eddylau328/fyp-artificial-intelligence-ac-control-device/item_list.md

# Item Lists
## AC Remote Device
### Electronic components
1. Arduino Mega 2560 x1
2. NodeMCU x1
    - [NodeMCU taobao link](https://detail.tmall.com/item.htm?id=524942473974&spm=a1z09.2.0.0.40b42e8dqUuZrI&_u=p2v57gsh5d21)
3. ir receiver x1
    - VS1838B , 38kHz
    - [VS1838B taobao link](https://item.taobao.com/item.htm?spm=a1z09.2.0.0.40b42e8dqUuZrI&id=178521861&_u=p2v57gshd1d6)
4. IR transmitter x1
    - IR LED
    - [IR LED taobao link](https://item.taobao.com/item.htm?spm=a1z09.2.0.0.40b42e8dqUuZrI&id=43647329043&_u=p2v57gshd036)
5. temperature & humidity sensor x1
    - HTU21D
    - [HTU21D taobao link](https://detail.tmall.com/item.htm?id=521686770579&spm=a1z09.2.0.0.40b42e8dqUuZrI&_u=p2v57gshe34b)
6. light sensor x1
    - BH1750
    - [BH1750 taobao link](https://detail.tmall.com/item.htm?id=521238059334&spm=a1z09.2.0.0.40b42e8dqUuZrI&_u=p2v57gshe0f9)
7. Barometric Pressor Sensor x1
    - BMP180
    - [BMP180 taobao link](https://detail.tmall.com/item.htm?id=521331189285&spm=a1z09.2.0.0.40b42e8dqUuZrI&_u=p2v57gsh1a64)

## Smartwatch Device
### Electronic components
1. Heart rate sensor x1
    - MAX30102
    - [MAX30102 taobao link](https://detail.tmall.com/item.htm?spm=a1z0d.6639537.1997196601.31.53377484Wh1uwb&id=576026624239)
2. Body temperature sensor x1
    - LM35
    - [LM35 taobao link](https://detail.tmall.com/item.htm?spm=a1z0d.6639537.1997196601.54.199b74845QygUJ&id=41414863412)
3. Low power LCD monitor x1
    - 0.96inch OLED monitor
    - [OLED monitor taobao link](https://detail.tmall.com/item.htm?spm=a1z0d.6639537.1997196601.28.199b74845QygUJ&id=555789848567)
4. ESP32 x1
    - bluetooth function provided
    - [esp32 taobao link](https://detail.tmall.com/item.htm?id=555740879447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)
5. Lithium Battery 3.7V x1
    - 2000 mah
    - [li battery taobao link](https://detail.tmall.com/item.htm?spm=a1z0d.6639537.1997196601.82.199b74845QygUJ&id=605011214807)
6. 3.3V DC-DC regulator
    - [regulator link](https://item.taobao.com/item.htm?spm=a1z09.2.0.0.74a22e8df6DqSQ&id=558518174418&_u=n2v57gsh9e70)

### Hardware components
1. wristband x1
    - [taobao link](https://detail.tmall.com/item.htm?spm=a1z0d.6639537.1997196601.14.bf1e7484fpfouG&id=585651198278)

## Power Meter
### Electronic components
1. Plug-in Power meter x1
    - [taobao link](https://detail.tmall.com/item.htm?spm=a1z0d.6639537.1997196601.119.199b74845QygUJ&id=590305202754)
2. Power meter module x1
    - PZEM-004T
    - [taobao link](https://item.taobao.com/item.htm?spm=a1z0d.6639537.1997196601.105.199b74845QygUJ&id=583138602232)
3. CT sensor x1
    - [taobao link](https://item.taobao.com/item.htm?spm=a1z0d.6639537.1997196601.105.199b74845QygUJ&id=583138602232)
4. atmega328 x1
    - [taobao link](https://detail.tmall.com/item.htm?spm=a1z0d.6639537.1997196601.4.199b74845QygUJ&id=595282328171)
5. LCD monitor x1
    - LCD 1602
    - [taobao link](https://detail.tmall.com/item.htm?spm=a1z0d.6639537.1997196601.72.199b74845QygUJ&id=16000820397)

## Air Conditioner
### PAC-208
[Carousell link](https://hk.carousell.com/p/%E7%A7%BB%E5%8B%95%E5%BC%8F%E5%86%B7%E6%B0%A3%E6%A9%9F-255165199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)
