eddylau328/fyp-artificial-intelligence-ac-control-device/fyp presentation/d13134be-79b7-4a4c-ba2b-299e0d3491b8.jpeg

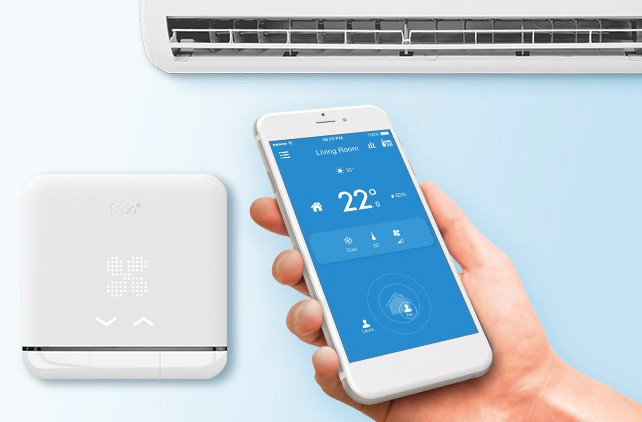
fyp presentation/d13134be-79b7-4a4c-ba2b-299e0d3491b8.jpeg
