eddylau328/fyp-artificial-intelligence-ac-control-device/fyp presentation/nuevo-mijia-smart-air-conditioner-2.jpg

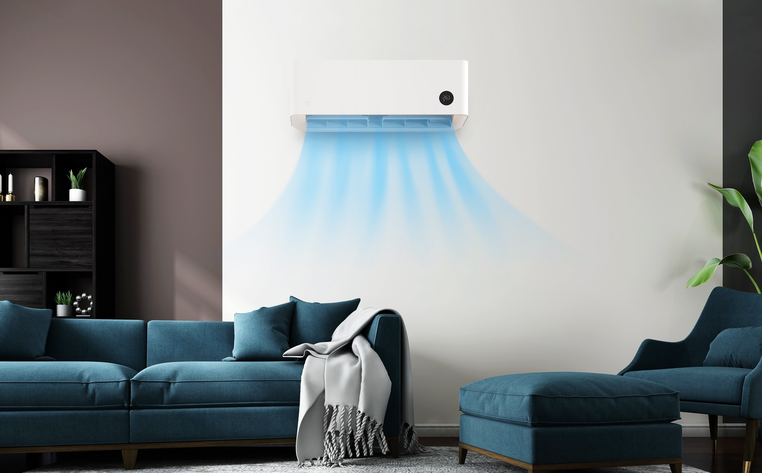
fyp presentation/nuevo-mijia-smart-air-conditioner-2.jpg
