eddylau328/fyp-artificial-intelligence-ac-control-device/fyp presentation/Screenshot from 2020-05-10 17-11-20.png

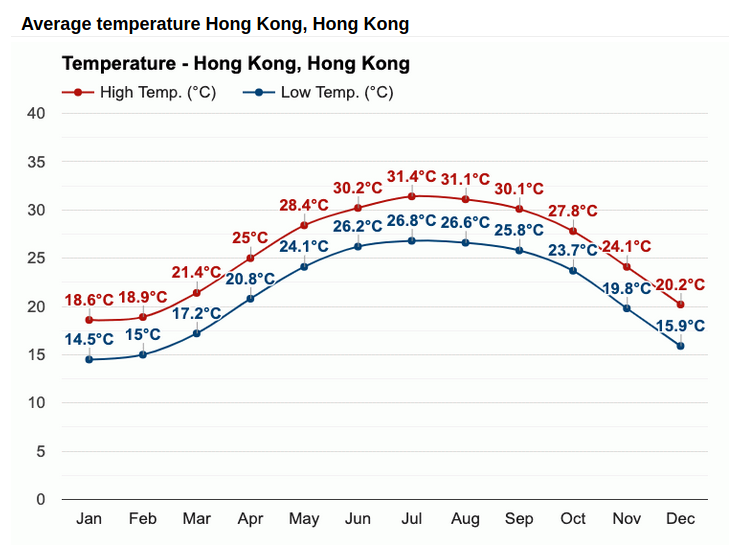
fyp presentation/Screenshot from 2020-05-10 17-11-20.png
