eddylau328/fyp-artificial-intelligence-ac-control-device/fyp presentation/Screenshot from 2020-05-11 08-19-18.png

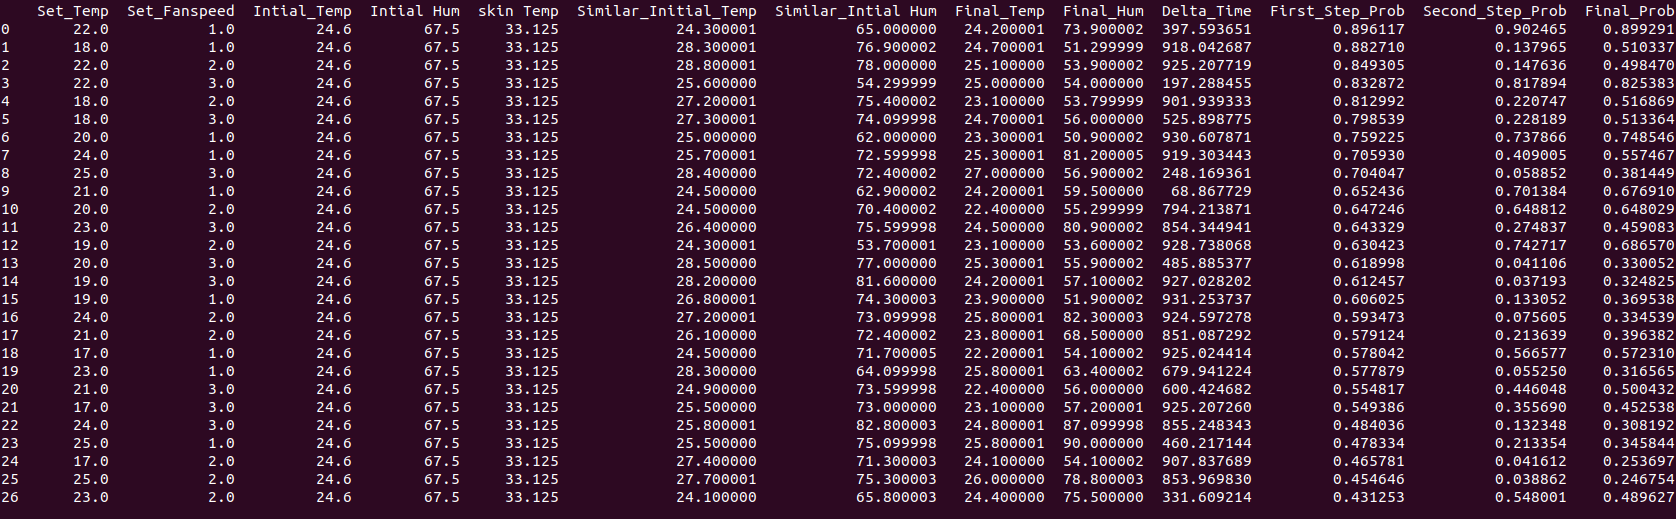
fyp presentation/Screenshot from 2020-05-11 08-19-18.png
