eddylau328/fyp-artificial-intelligence-ac-control-device/Machine_Learning/Supervised Learning Model.png

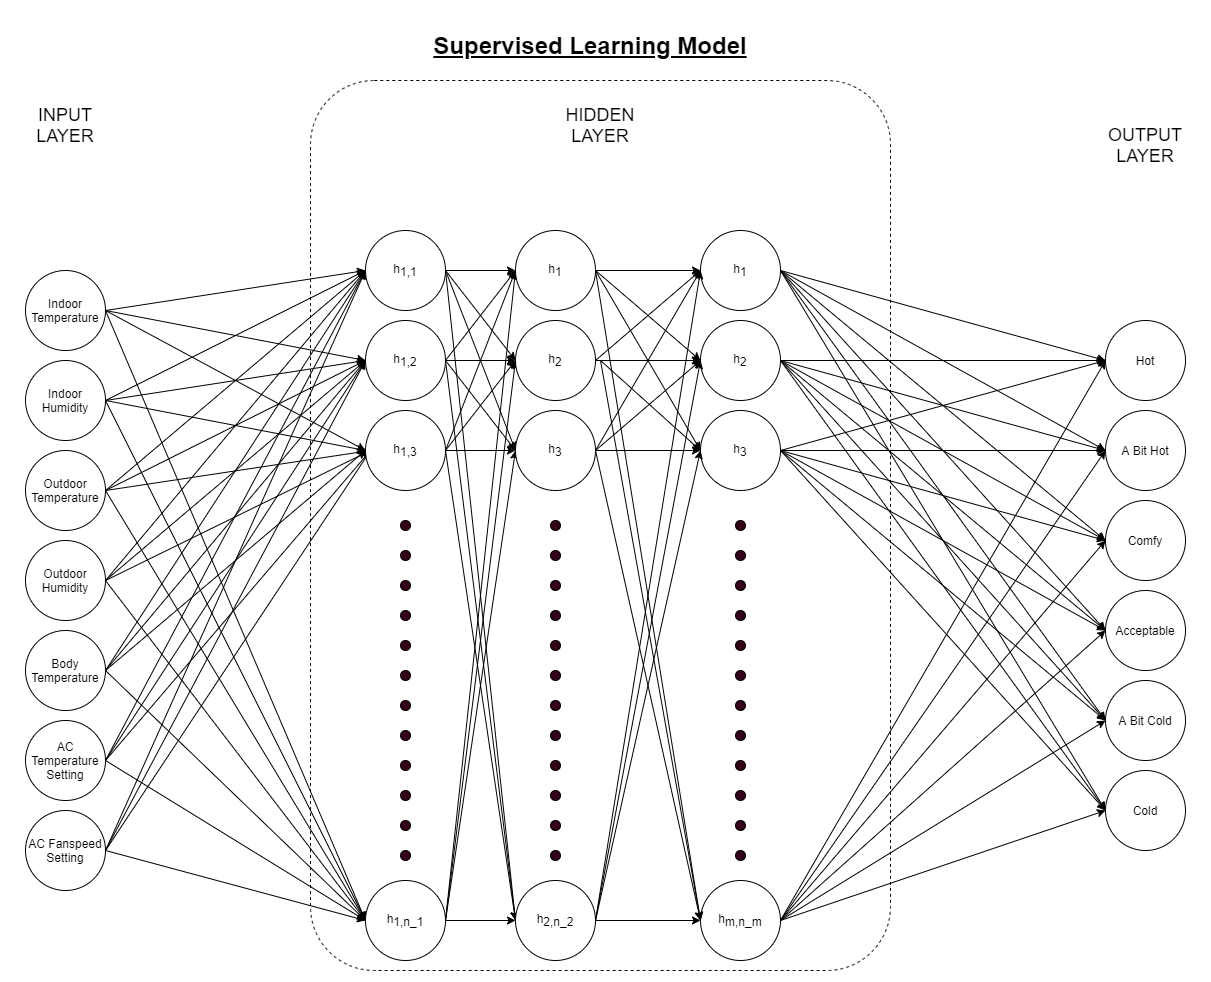
Machine_Learning/Supervised Learning Model.png
