eddylau328/fyp-artificial-intelligence-ac-control-device/Project Record/AC remote DEV/Online database communication/pic_send_data_to_firebase_connection.jpeg

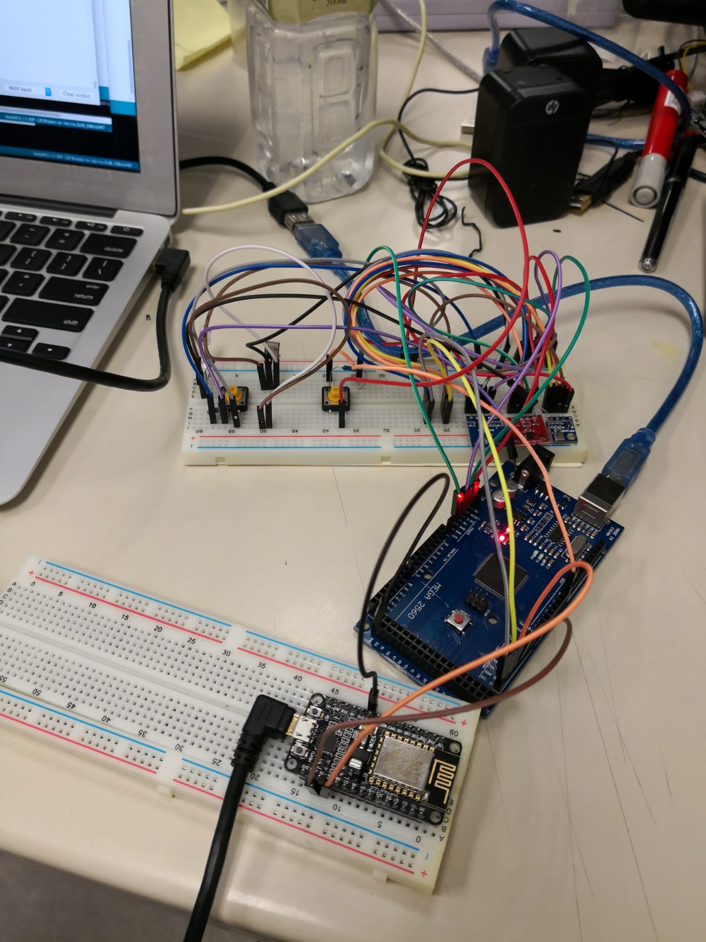
Project Record/AC remote DEV/Online database communication/pic_send_data_to_firebase_connection.jpeg
