eddylau328/fyp-artificial-intelligence-ac-control-device/Project Record/explaination/3_plot_temp_hum_skin.png

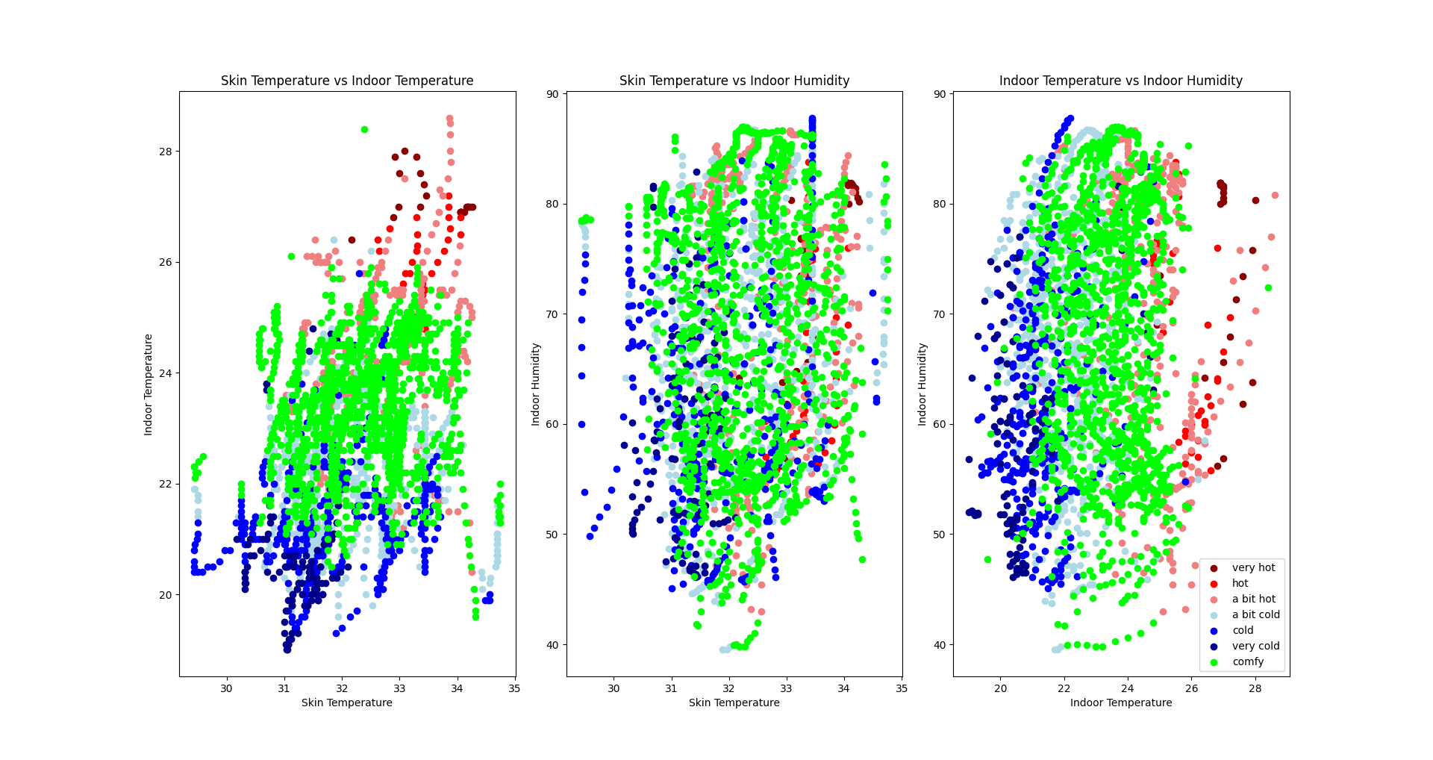
Project Record/explaination/3_plot_temp_hum_skin.png
