eddylau328/fyp-artificial-intelligence-ac-control-device/Project Record/explaination/3d_plot_temp_hum_skin_temp.png

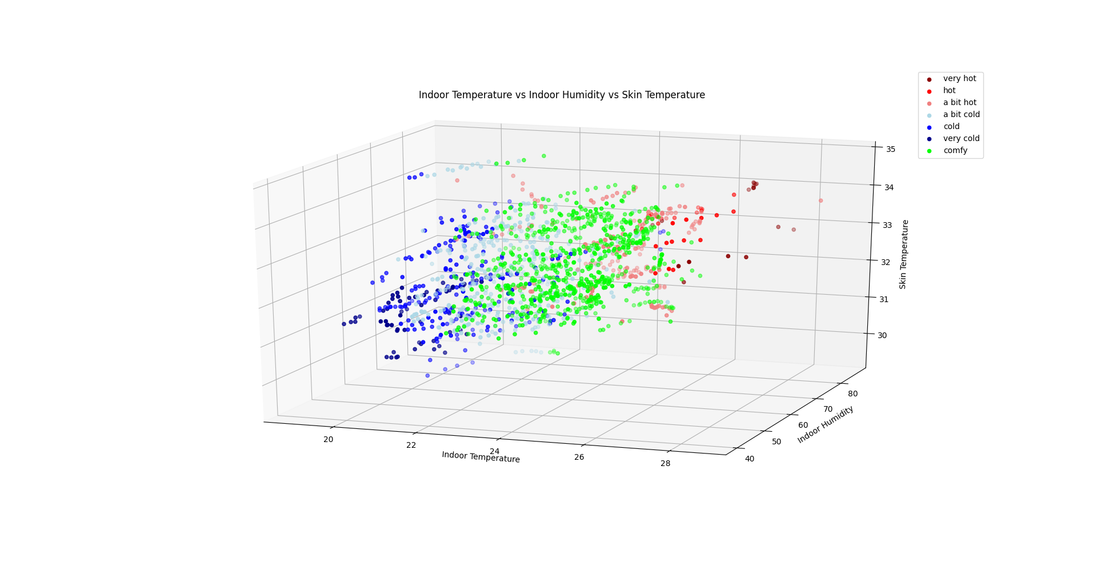
Project Record/explaination/3d_plot_temp_hum_skin_temp.png
