eddylau328/fyp-artificial-intelligence-ac-control-device/Project Record/explaination/correlation_heatmap.png

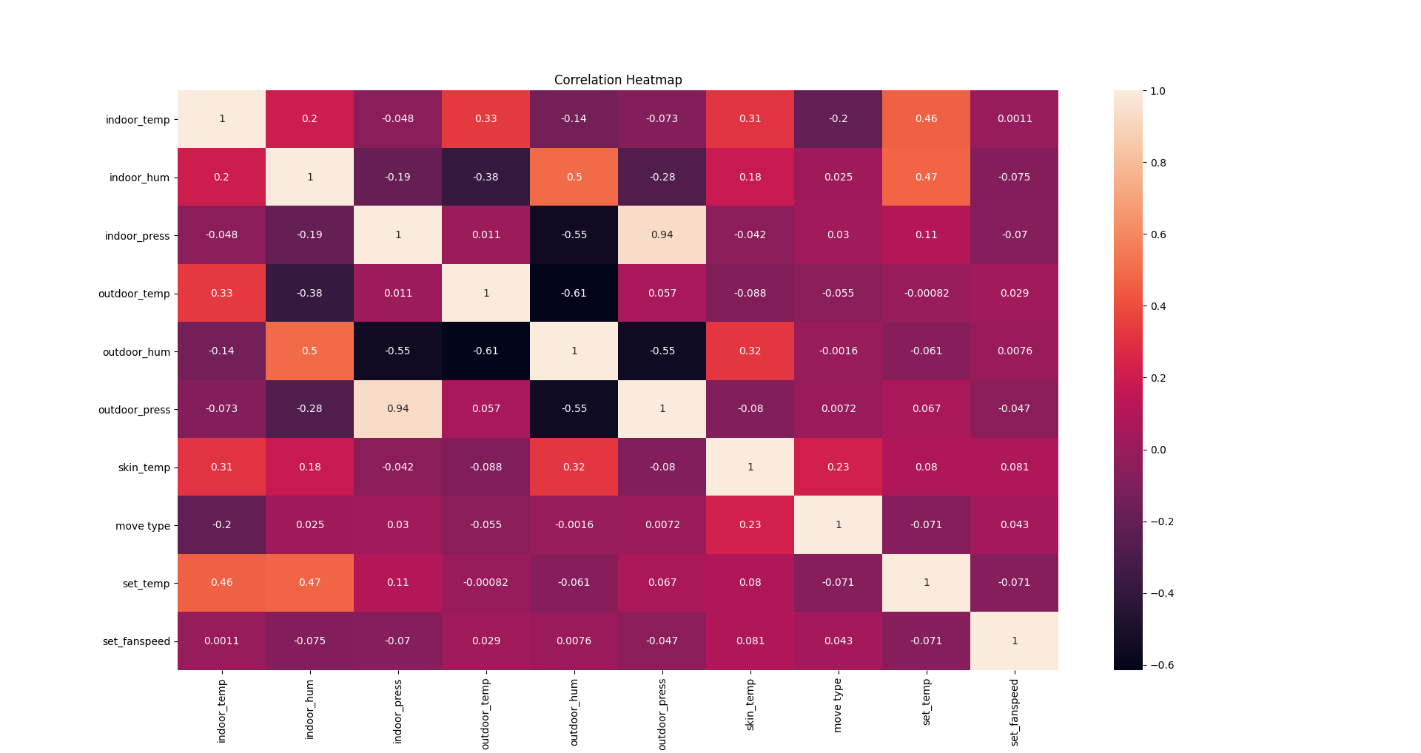
Project Record/explaination/correlation_heatmap.png
