eddylau328/fyp-artificial-intelligence-ac-control-device/Project Record/explaination/firebase_realtime_database_class_diagram.png

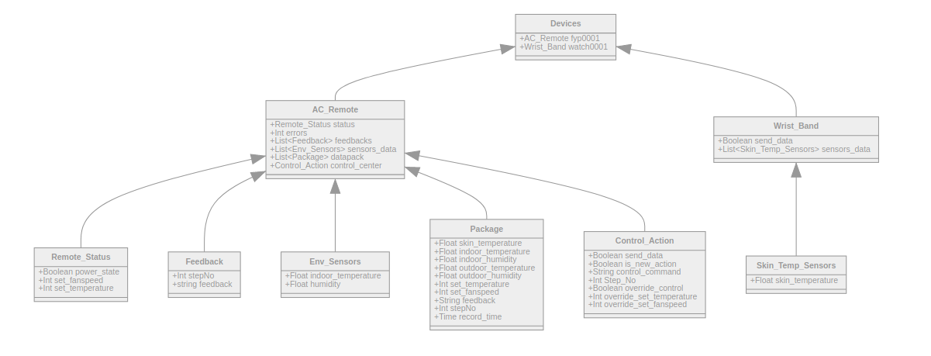
Project Record/explaination/firebase_realtime_database_class_diagram.png
