eddylau328/fyp-artificial-intelligence-ac-control-device/Project Record/explaination/indoor_humidity_thermal_comfort_level_probability_density.png

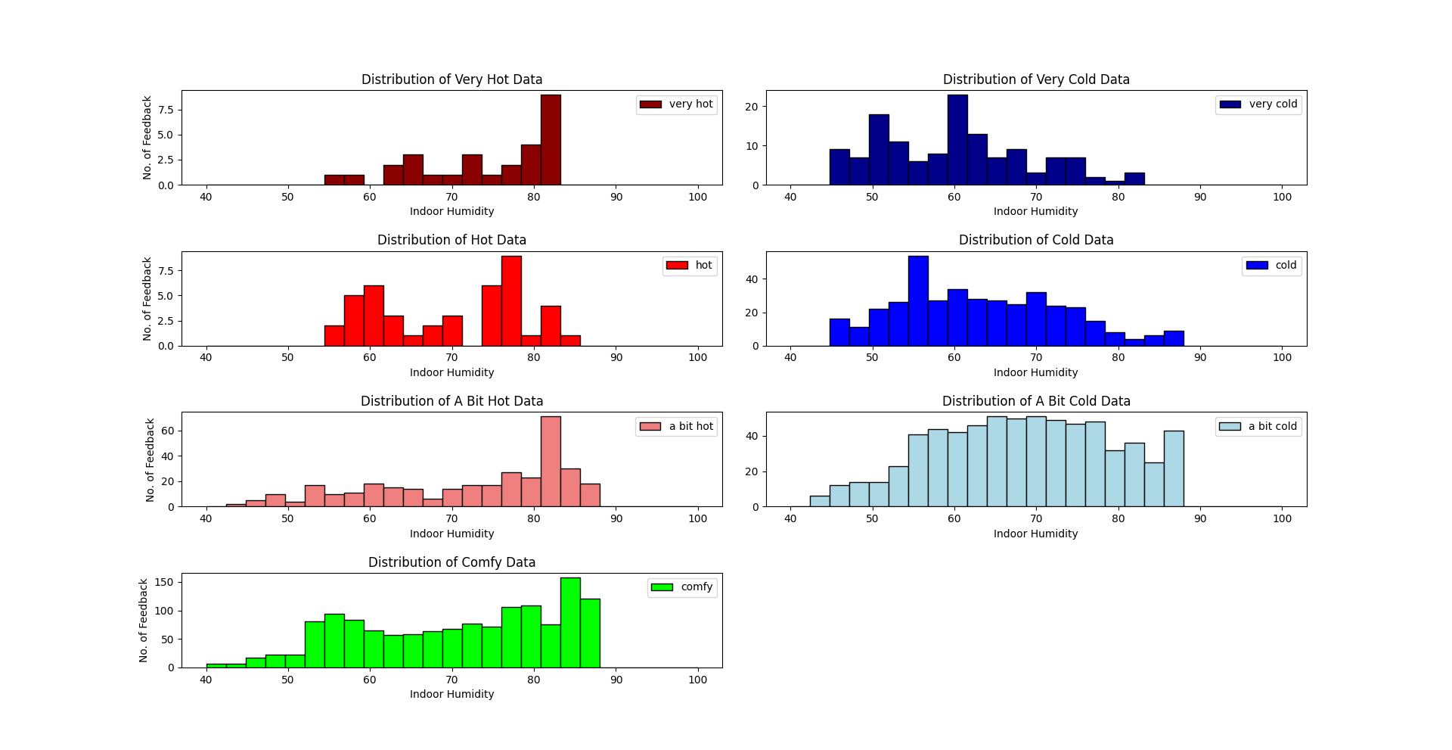
Project Record/explaination/indoor_humidity_thermal_comfort_level_probability_density.png
