eddylau328/fyp-artificial-intelligence-ac-control-device/Project Record/explaination/simple_NN_sample_explaination.png

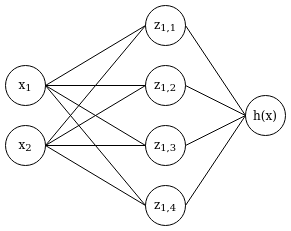
Project Record/explaination/simple_NN_sample_explaination.png
