eddylau328/fyp-artificial-intelligence-ac-control-device/Project Record/explaination/state_machine_diagram.png

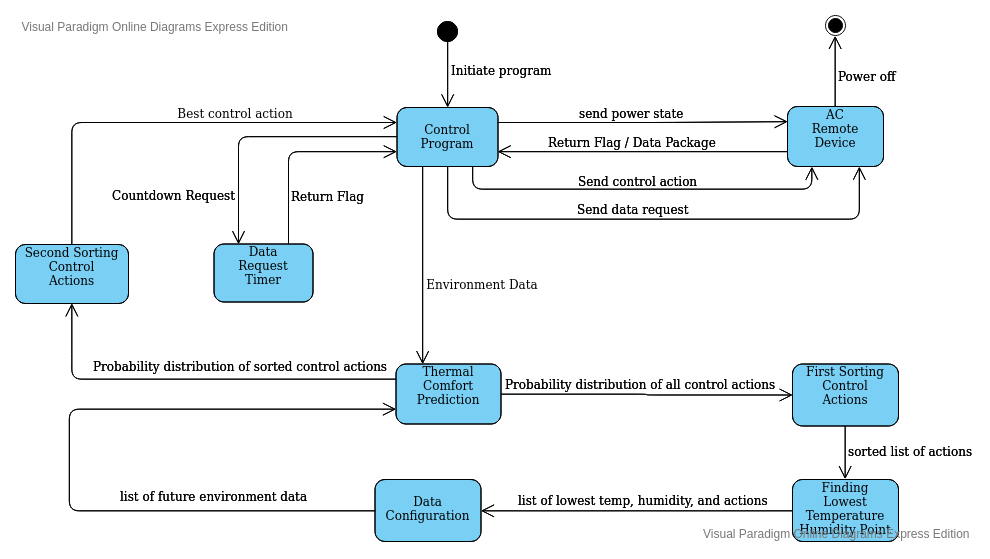
Project Record/explaination/state_machine_diagram.png
