eddylau328/fyp-artificial-intelligence-ac-control-device/Project Record/explaination/Supervised Learning Model.png

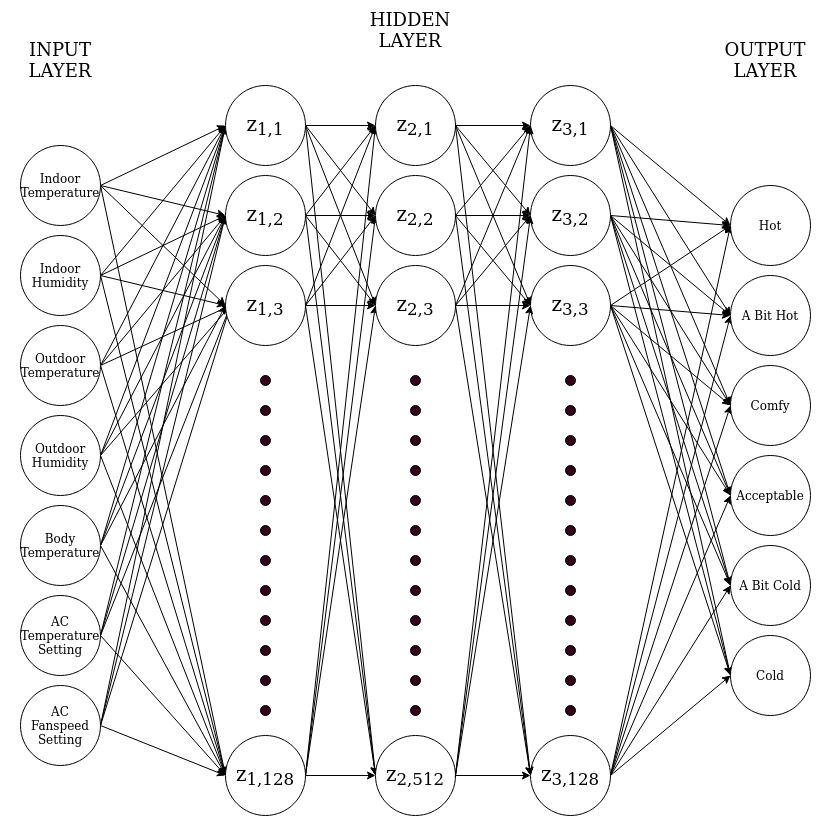
Project Record/explaination/Supervised Learning Model.png
