eddylau328/fyp-artificial-intelligence-ac-control-device/Project Record/IMG_20200501_230633.jpg

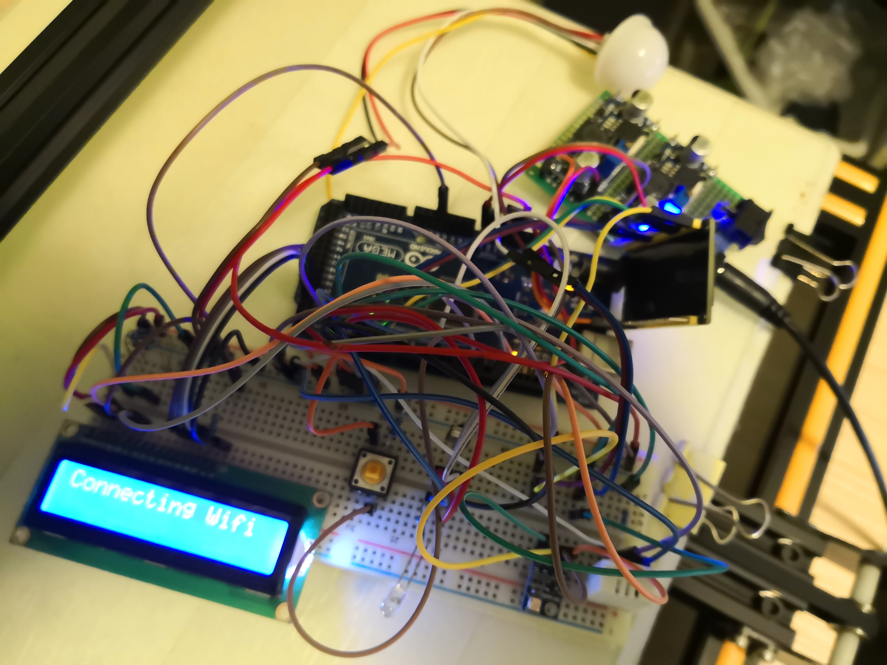
Project Record/IMG_20200501_230633.jpg
