eddylau328/fyp-artificial-intelligence-ac-control-device/Project Record/IMG_20200501_230823.jpg

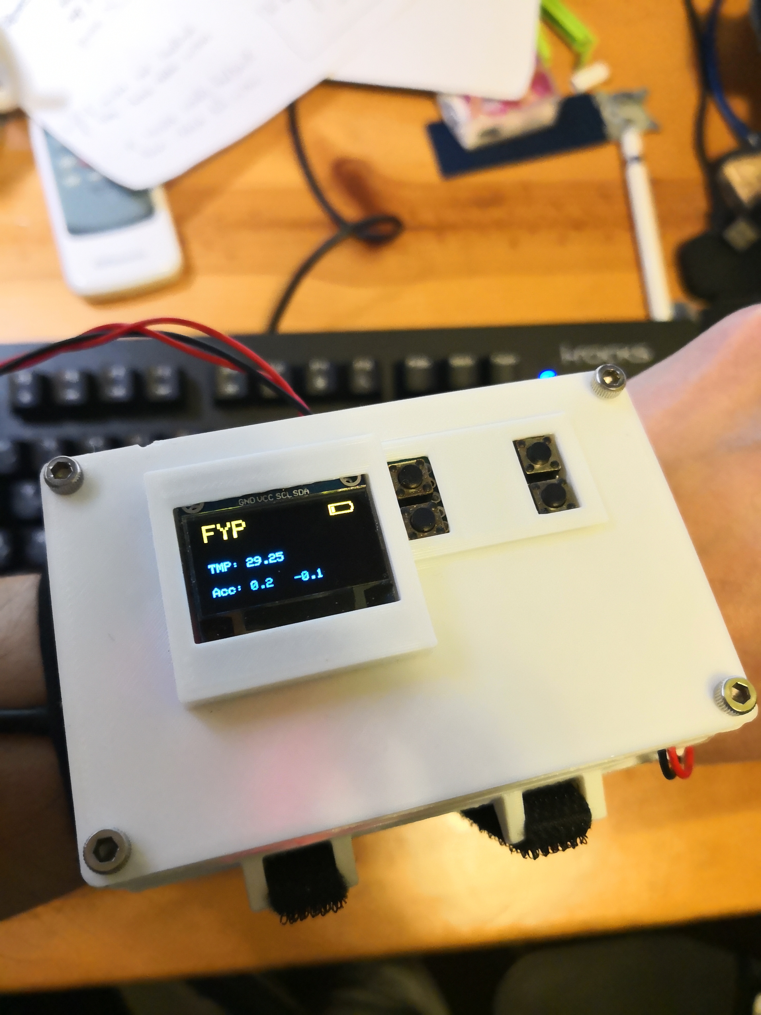
Project Record/IMG_20200501_230823.jpg
