eddylau328/fyp-artificial-intelligence-ac-control-device/Project Record/item_list_photo/htu21d.jpg

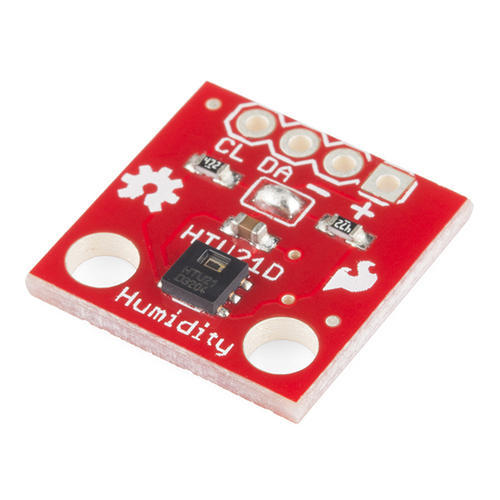
Project Record/item_list_photo/htu21d.jpg
