eddylau328/fyp-artificial-intelligence-ac-control-device/Project Record/item_list_photo/PZEM-004T.jpg

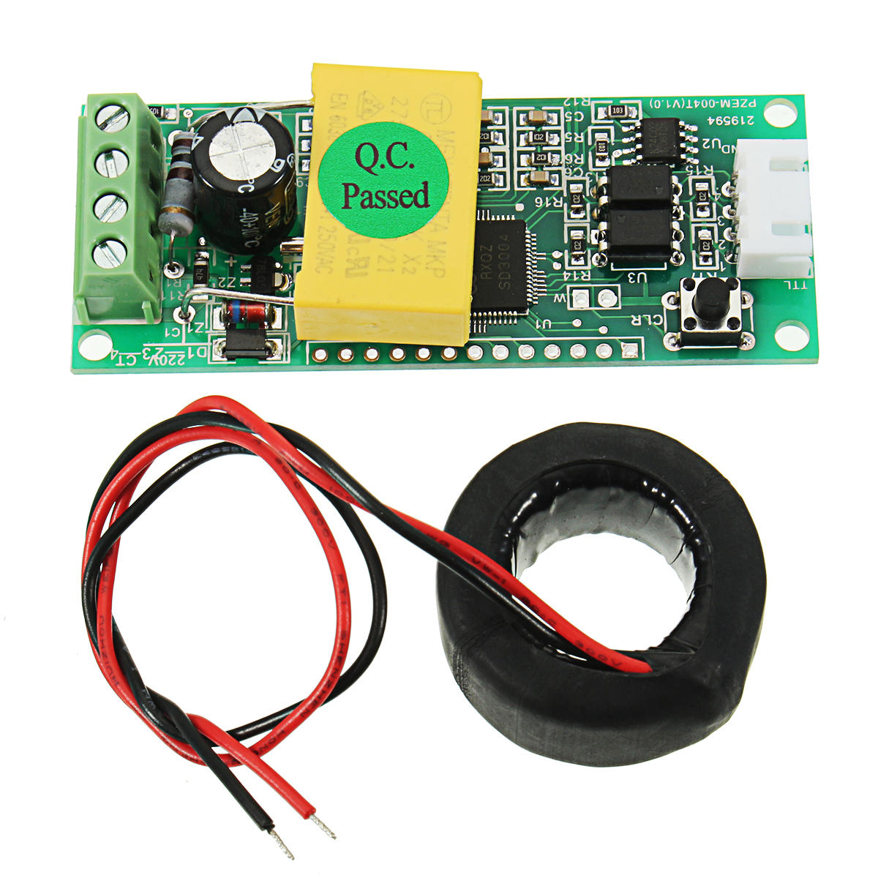
Project Record/item_list_photo/PZEM-004T.jpg
