eddylau328/fyp-artificial-intelligence-ac-control-device/Project Record/mobile_app/mobile_app_feedback_collection.jpeg

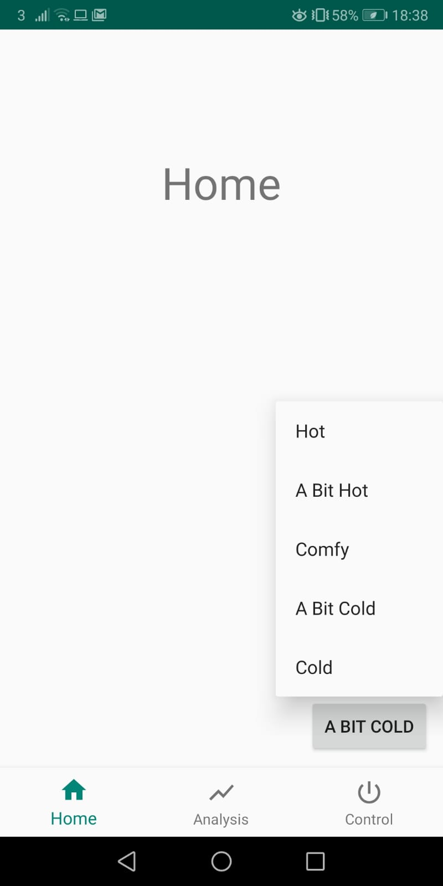
Project Record/mobile_app/mobile_app_feedback_collection.jpeg
