eddylau328/fyp-artificial-intelligence-ac-control-device/Smartwatch Device/3d part/smartwatch_middle v16.stl

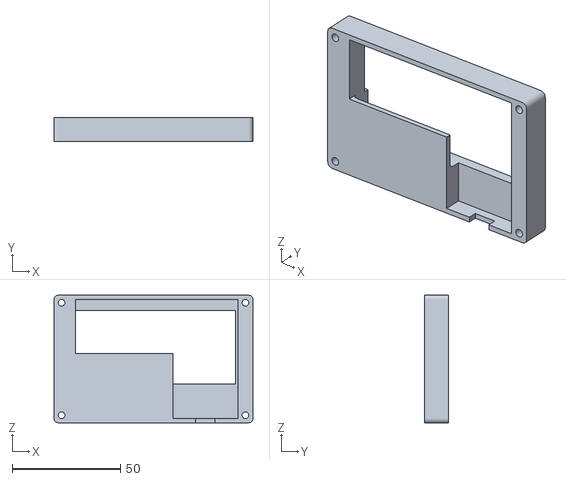
[picture p77: CAD file, 2020-05-01]
Smartwatch Device/3d part/smartwatch_middle v16.stl
92.0 x 11.0 x 59.0
