eddylau328/fyp-artificial-intelligence-ac-control-device/Smartwatch Device/3d part/smartwatch_base v18.stl

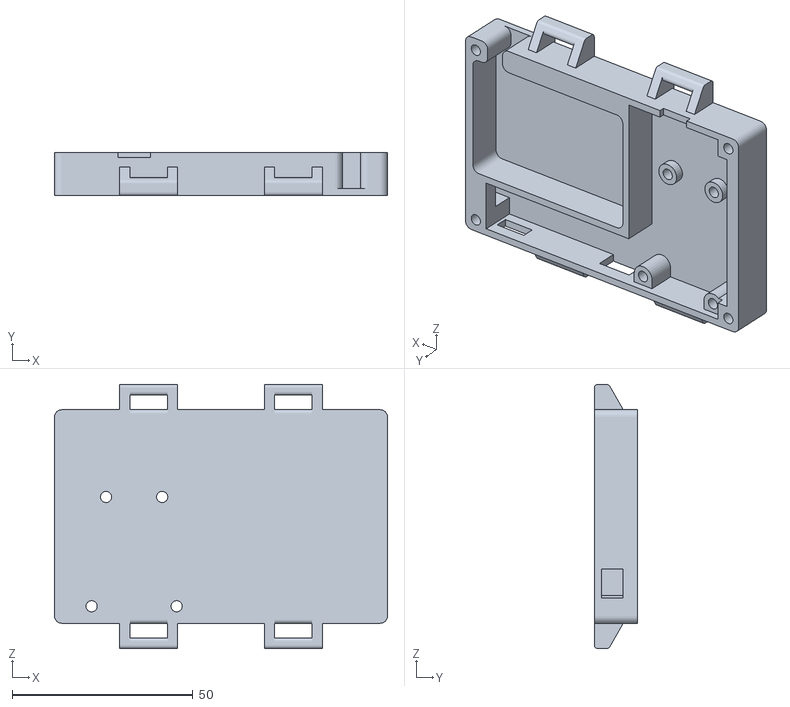
[picture p78: CAD file, 2020-05-01]
Smartwatch Device/3d part/smartwatch_base v18.stl
92.0 x 12.0 x 73.0
