eddylau328/fyp-artificial-intelligence-ac-control-device/Smartwatch Device/3d part/smartwatch_close v16.stl

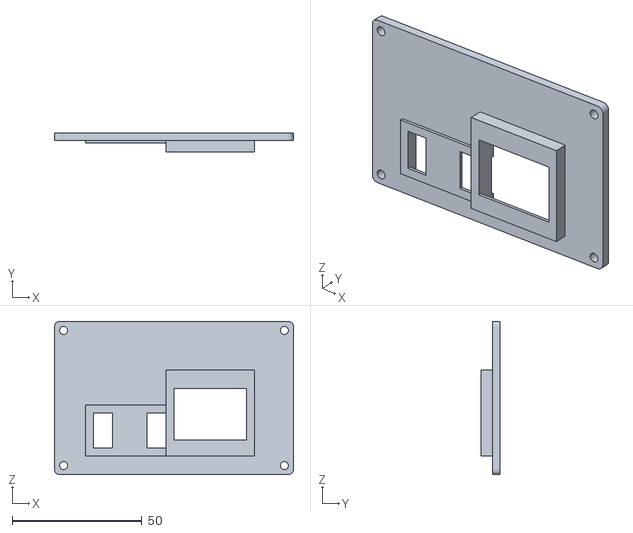
[picture p79: CAD file, 2020-05-01]
Smartwatch Device/3d part/smartwatch_close v16.stl
92.0 x 7.50 x 59.0
