eddylau328/fyp-artificial-intelligence-ac-control-device/fyp presentation/close-up-man-hand-operating-air-conditioner-with-remote-control_51530-843.jpg

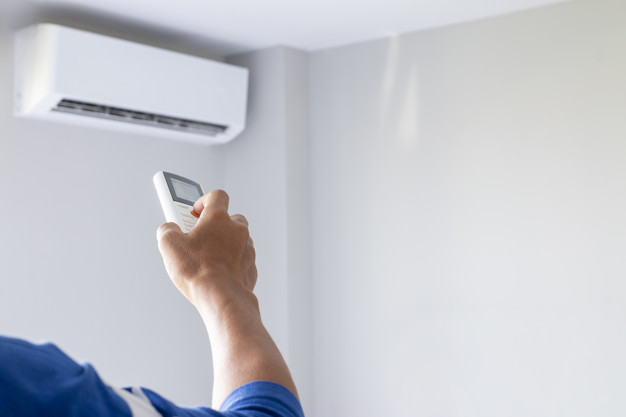
fyp presentation/close-up-man-hand-operating-air-conditioner-with-remote-control_51530-843.jpg
