eddylau328/fyp-artificial-intelligence-ac-control-device/(commit log)

2019-11-11 Update item_list.md, add Power meter and Smartwatch component, and air conditioner.
2019-11-25 Added 3 main folders to save different devices files
2019-11-25 Modify the names of each device
2019-11-25 Upload AC Remote Device Electronic Diagram
2019-11-25 Updated with IR LED and VS1838B part
2019-11-25 Added 100ohm resistor to IR LED
2019-11-30 Added the development process in AC remote device README.md
2019-12-29 Changes about the software serial port, change to rx tx on arduino mega
2020-01-08 modified the nodeMCU code for hiding the pw and push to 'sensors' instead of 'senors/data/'
2020-01-11 Added a button to go to login activity
2020-01-13 added three 3.3k ohm resistors to the lcd screen in AC remote
2020-01-14 Added DC power input regulator module
2020-01-14 Added 3 sensors datasheet
2020-01-15 update arduino code
2020-01-17 add firebase_design.md and revert ArduinoCode and NodeMCUCode
    [ArduinoMegaCode.ino, NodeMCUCode.ino]
2020-01-18 added timer function on the nodemcu and added receive function on the mega, not test yet
2020-01-20 Added MPU6050.zip and i2cdevlib.zip
2020-01-25 Added buttons library
2020-01-26 Added button switch to different page function
2020-01-26 Finish button switch page basic function and add move and temp page basic show function
2020-01-27 fixed display bug and modified display_pic function
    [Smartwatch_without_battery.ino]
2020-01-27 Added battery power level at nav_bar
2020-02-10 added timer library
2020-02-11 smartwatch can push data to the firebase, smartwatch display can clear current page
2020-02-15 modify smartwatch to take accelerometer data in 4Hz and send data to firebase each second
2020-02-18 ac remote arduino and nodemcu add another serial communication way
2020-02-19 added some print function on smartwatch_learning.py to display more clear on the terminal
2020-03-14 added arduino library folder
2020-03-18 slighlty modify the IRmonitor.h and implemented the IR control in the final arduino mega 2560 code
2020-03-18 added read serial communication command in ACremote arduino mega 2560 code
2020-03-20 firebase connection has problem, software serial is not stable
    [ArduinoMegaCode.ino, NodeMCUCode.ino]
2020-03-20 added interrupt timer to esp32_code
2020-03-21 switched from nodemcu to esp32
2020-03-22 mobile app control fragment add switch button
2020-03-23 ac remote: fixed bugs, added data poll function, update ac setting to firebase
    [ArduinoMegaCode.ino, ESP32Code.ino]
2020-03-25 corrected smartwatch.ino and ac_generate_data.py
    [ESP32Code.ino, Smartwatch.ino]
2020-03-25 fixed minor bugs in both smartwatch script and esp32 script
    [ESP32Code.ino, Smartwatch.ino]
2020-04-01 mobile app: can show x-axis time data, show about 1 hour data
2020-04-01 power meter: basic serial communcation between arduino nano and pc
2020-04-01 power meter: python script added ping-pong communication
2020-04-02 added power meter code, but it will not continue
2020-04-11 modified acceptable feedback, and added machine_learning.yml
    [machine_learning.yml]
2020-04-12 fixed ds18b20
    [machine_learning.yml]
2020-04-26 mobile app: modify no data bug
    [ESP32Code.ino, Smartwatch.ino]
2020-04-29 added dqn env, and updated dqn
    [ac-control-dqn-detail.csv]
2020-04-30 give up on DQN XD
    [ac-control-dqn-detail.csv, best_episodes.csv]
